kaistseed/jahwa-project/README.md

<table width="100%" align="center" style="border:0px solid white;>
 <tr width="100%">
    <td align="center">
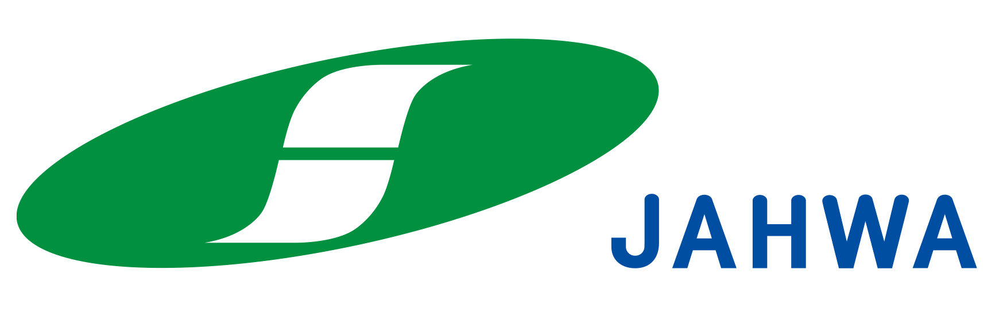
[picture p1: documentation/resources/jahwa.png]
     <h1>Jahwa Project - Data Acquisition System</h1>
    </td>
 </tr>
</table>

## Repository Content

 <table style="width:100%" align="center">
 <tr>
 <td align="center"><b>Content</b>
 <td align="center"><b>Target / Platform</b>
 <td align="center"><b>Note</b>
 </tr>
 <tr>
 <td align="center"><a href="https://github.com/kaistseed/jahwa-project/tree/main/fpga-board/vivado-project">Vivado Project Guide</a></td>
 <td align="center">FPGA Board</td>
 <td align="center">Contains tutorial and necessary files to build an FPGA overlay using Xilinx Vivado tools</td>
 </tr>
 <tr>
 <td align="center"><a href="https://github.com/kaistseed/jahwa-project/tree/main/fpga-board/vitis-project">Vitis Project Guide</a></td>
 <td align="center">FPGA Board</td>
 <td align="center">Contains tutorial and necessary files to create firmware for controlling the MicroBlaze processor and other IP blocks</td>
 </tr>
 <tr>
 <td align="center"><a href="">Board Calibration Guide</a></td>
 <td align="center">Host PC and FPGA Board</td>
 <td align="center">Contains files that are required to perform board calibration</td>
 </tr>
 <tr>
 </table>
