kaistseed/jahwa-project/documentation/resources/bd-automation-tcl.png

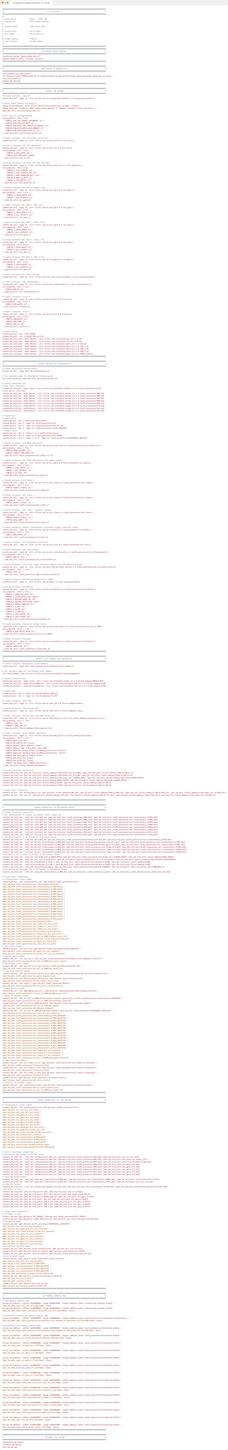
documentation/resources/bd-automation-tcl.png
