kaistseed/jahwa-project/documentation/resources/gpio-emio.png

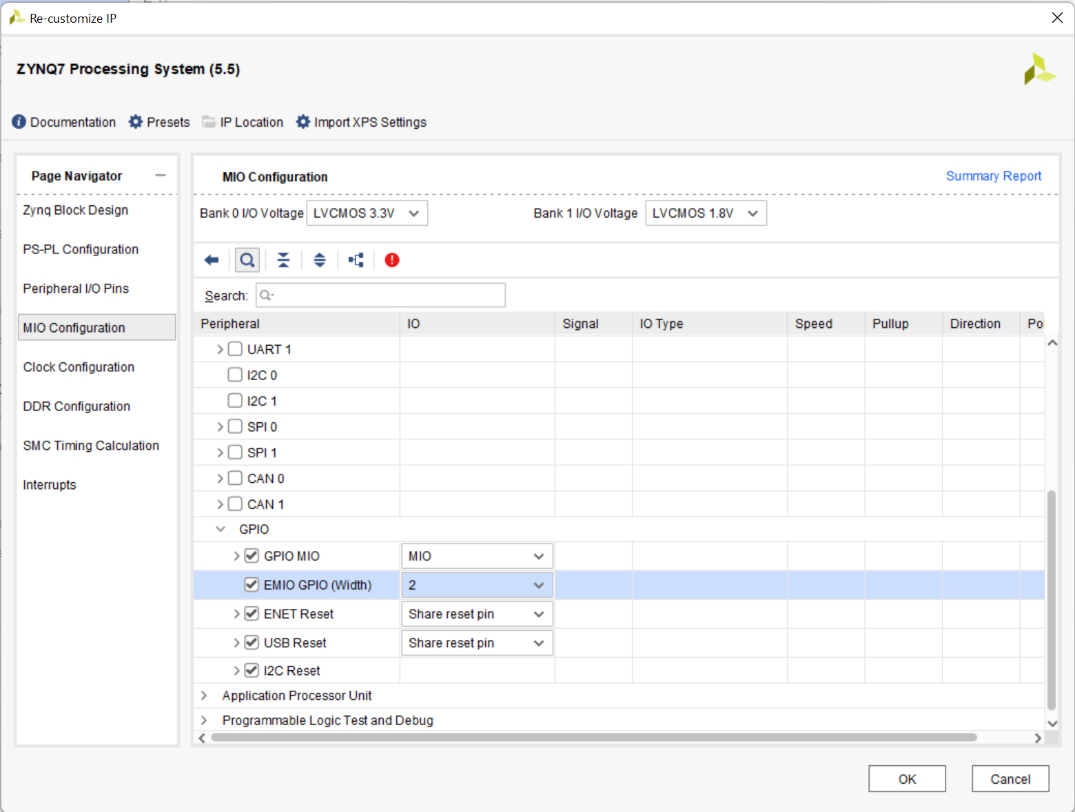
documentation/resources/gpio-emio.png
