kaistseed/jahwa-project/documentation/resources/initial-bd.png

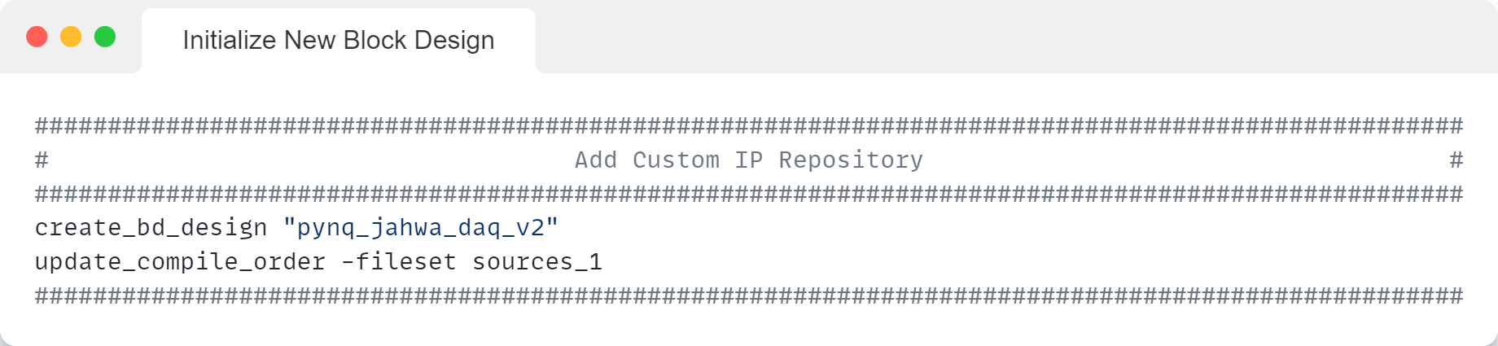
documentation/resources/initial-bd.png
