kaistseed/jahwa-project/documentation/resources/zynq-interrupt.png

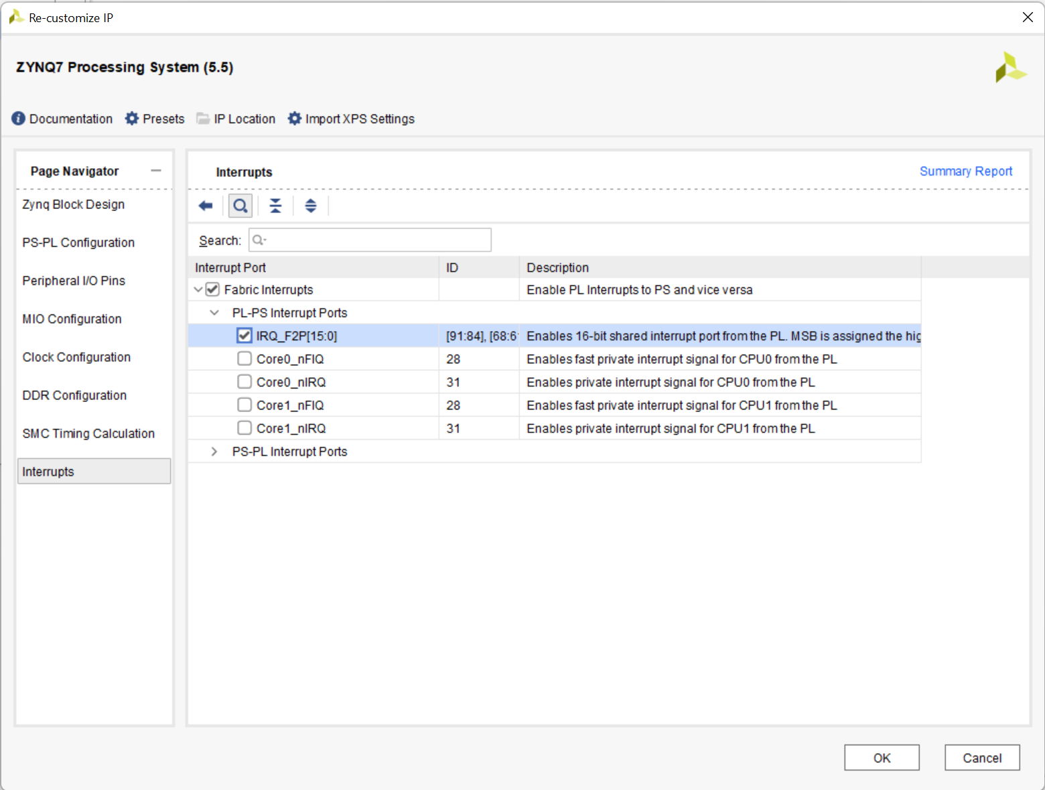
documentation/resources/zynq-interrupt.png
