kaistseed/jahwa-project/pcb-board/Jahwa_2 BOM v2.xlsx

Comment | Description | Designator | Footprint | LibRef | Quantity | Unit price[KRW] | Total price | How many we will send | Link
100n | Multi-layer Ceramic Capacitor, -55 to 125 degC, 2-Pin SMD (0603), RoHS, Tape and Reel | C100, C101, C105, C106, C109, C110, C114, C115, C201, C204, C302A, C302O, C303A, C303O, C304A, C304O, C306A, C306O, C307A, C307O, C308A, C308O, C309A, C309O, C400, C401, C402, C408, C409, C410, C500, C502, C503, C504, C505, C600, C601 | SAMS-C0603-2_M | CMP-2000-05332-1 | 37 | 0 | 0
10uF 16V 3528 | CAP TANT 10UF 10% 20V 1411 | C102, C103, C104, C107, C108, C111, C112, C200, C403, C406, C501 | FP-T491B106K020AT-MFG | CMP-2000-07191-2 | 11 |  | 0
10n | CAP CER 10000PF 200V X7R 0603 | C113, C116 | FP-C0603C-CF-MFG | CMP-2006-03038-2 | 2 |  | 0
100u 25V | CAP TANT 100UF 10% 25V 2917 | C117, C300A, C300O, C301A, C301O | FP-T491X107K025AT-MFG | CMP-2000-07204-2 | 5 |  | 0
2.2uF | Cap Ceramic 2.2uF 10V X7R ±10% Pad SMD 0603 +125°C T/R | C202 | FP-CL10-IPC_A | CMP-13271-003582-1 | 1 |  | 0
47uF 3528 | 47uF 10V ±10% 1Ω 1210 SMD Tantalum Capacitor | C203 | FP-TAJB-MFG | CMP-04424-000629-1 | 1 |  | 0
1u |  | C404, C405 | CAPC2013X70X45NL10T25 | CMP-2007-00957-1 | 2 |  | 0
BAT54HT1G | Schottky Barrier Diode, 2-Pin SOD-323, Pb-Free, Tape and Reel | D300A, D300O | ONSC-SOD-323-2-477-02_V | CMP-1055-00462-1 | 2 | 219.9 | 439.8 |  | https://www.mouser.kr/ProductDetail/onsemi/BAT54HT1G?qs=vLkC5FC1VN%252BK3ZQA%252ByHPIA%3D%3D
G6K-2F-Y DC3 | RELAY TELECOM DPDT 1A 3VDC | K300A, K300O | FP-G6K-2F-Y_DC3-MFG | CMP-08823-000016-1 | 2 | 5800.70 | 11601.4 |  | https://www.mouser.com/ProductDetail/Omron-Electronics/G6K-2F-DC3?qs=eORE%252BZ%252B0Crt4AHji2fVKVw%3D%3D
3mm |  | MNT1, MNT2, MNT3, MNT4 | 3mm Hole | Hole 3mm | 4 |  | 0
691311500102 | Serie 311 - 5.08mm Close Vertical PCB Header WR-TBL, 2 pin | P100 | 691311500102 | CMP-1502-02146-1 | 1 |  | 0 | 3
B4B-PH-K-S(LF)(SN) | Male Header, Pitch 2 mm, 1 x 4 Position, Height 6 mm, Tail Length 3.4 mm, -25 to 85 degC, RoHS, Bulk | P400, P402 | JST-B4B-PH-K-S_V | CMP-2000-05165-1 | 2 |  | 0
22035085 | 2.50mm Pitch, Mini-SPOX PCB Header, Single Row, Vertical, Through Hole, Tin Plating, 8 Circuits, Bag, 3.50mm PC Tail Length | P401 | MOLEX_22035085 | 22035085 | 1 |  | 0 | 10+
61300211121 | THT Vertical Pin Header WR-PHD, Pitch 2.54 mm, Single Row, 2 pins | P600 | 61300211121 | CMP-1712-00002-4 | 1 |  | 0
Pynq3 | Header, 10-Pin | P700 | HDR1X10 | Header 10 | 1 |  | 0
Pynq 1 | Header, 8-Pin | P701 | HDR1X8 | Header 8 | 1 |  | 0
Pynq 4 | Header, 8-Pin | P702 | HDR1X8 | Header 8 | 1 |  | 0
Pynq 2 | Header, 6-Pin | P703 | HDR1X6 | Header 6 | 1 |  | 0
MMBT3904LT1G | General Purpose Transistor, NPN Silicon, 3-Pin SOT-23, Pb-Free, Tape and Reel | Q300A, Q300O | ONSC-SOT-23-3-318-08_V | CMP-1048-00631-1 | 2 | 144.3 | 288.6 |  | https://www.mouser.kr/ProductDetail/onsemi/MMBT3904LT1G?qs=HVbQlW5zcXUYZ2Fy0YF3FQ%3D%3D
9k1 |  | R100 | RESC1608X55X30ML15T15 | CMP-2000-00683-1 | 1 |  | 0
100k |  | R101 | RESC1608X55X30ML15T15 | CMP-2000-00182-1 | 1 |  | 0
100R |  | R200, R201, R203, R204, R205, R500, R501, R502 | RESC1608X55X30ML15T15 | CMP-2000-00179-1 | 8 |  | 0
3k3 | Chip Resistors, 3.3 KOhm, +/- 1%, 0.1 W, 0603 (1608 Metric), -55 to 155 degC, RoHS, Tape and Reel | R202, R301A, R301O, R407, RP400 | RESC1609X55X30ML15T15 | CMP-2000-00436-2 | 5 |  | 0
24k |  | R300A, R300O | RESC1608X55X30ML15T15 | CMP-2000-00362-1 | 2 |  | 0
6k2 |  | R302A, R302O | RESC1608X55X30ML15T15 | CMP-2000-00594-1 | 2 |  | 0
0.2R 2012(0805) | RES Thick Film, 0.2Ω, 1%, 0.125W, 100ppm/°C, 0805 | R303A, R303O, R402 | RESC2013X46X38ML25T25 | CMP-2001-04350-1 | 3 | 370.8 | 1112.4 |  | https://www.digikey.kr/en/products/detail/stackpole-electronics-inc/CSR0805FKR200/1742442
12k |  | R304A, R304O | RESC1608X55X30ML15T15 | CMP-1012-00057-2 | 2 |  | 0
1.2k | Chip Resistor, 1.2 KOhm, +/- 1%, 0.1 W, -55 to 155 degC, 0603 (1608 Metric), RoHS, Tape and Reel | R305A, R305O, R403 | RESC1609X55X30ML15T15 | CMP-2000-00214-2 | 3 |  | 0
15k |  | R306A, R306O, R400 | RESC1608X55X30ML15T15 | CMP-2000-00460-1 | 3 |  | 0
10k |  | R307A, R307O, R312A, R312O, R401 | RESC1608X55X30ML15T15 | CMP-1012-00109-2 | 5 |  | 0
22R | Chip Resistor, 22 Ohm, +/- 1%, 0.1 W, -55 to 155 degC, 0603 (1608 Metric), RoHS, Tape and Reel | R308A, R308O | RESC1608X55X30ML15T15 | CMP-1012-00320-3 | 2 |  | 0
11k |  | R309A, R309O, R404 | RESC1608X55X30ML15T15 | CMP-2000-00199-1 | 3 |  | 0
1k |  | R310A, R310O, R405 | RESC1608X55X30ML15T15 | CMP-2000-00180-1 | 3 |  | 0
100R 0805 | RES Thick Film, 100Ω, 1%, 0.125W, 100ppm/°C, 0805 | R311A, R311O | FP-CRCW0805-e3-MFG | CMP-1013-00397-3 | 2 | 2214.30 | 4428.6 |  | https://www.digikey.kr/en/products/detail/stackpole-electronics-inc/RNCF0805TKY100R/2269699
10k | Chip Resistor, 10 KOhm, +/- 1%, 0.1 W, -55 to 155 degC, 0603 (1608 Metric), RoHS, Tape and Reel | R406 | RESC1609X55X30ML15T15 | CMP-1012-00623-3 | 1 |  | 0
20k | Chip Resistor, 10 KOhm, +/- 1%, 0.1 W, -55 to 155 degC, 0603 (1608 Metric), RoHS, Tape and Reel | R408 | RESC1609X55X30ML15T15 | CMP-1012-00623-3 | 1 |  | 0
4k7 | Precision Thick Film Chip Resistor, 4.7 KOhm, +/- 1%, -55 to 155 degC, 0603 (1608 Metric), RoHS, Tape and Reel | R409 | RESC1608X55X30ML15T15 | CMP-1012-00586-3 | 1 |  | 0
2k |  | R410, R411, R412, R413 | RESC1608X55X30ML15T15 | CMP-2000-00317-1 | 4 |  | 0
120R |  | R503, R504, R505 | RESC1608X55X30ML15T15 | CMP-2000-00179-1 | 3 |  | 0
LM3940IMP-3.3 | 1A Low Dropout Regulator for 5V to 3.3V Conversion, 4-pin SOT-223 | U100 | DCY0004A_L | CMP-0062-01793-3 | 1 | 3575 | 3575 |  | https://www.digikey.com/en/products/detail/texas-instruments/LM3940IMP-3-3/3697827
L7809ABD2T-TR | Positive Voltage Regulator, 3-Pin D2PAK, Tape and Reel | U101 | TO-263_N | CMP-0244-00211-1 | 1 | 1528 | 1528 |  | https://www.digikey.kr/en/products/detail/stmicroelectronics/L7809ABD2T-TR/1038253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
LM2937IMP-5.0/NOPB | 500 mA Low Dropout Regulator, 4-pin SOT-223, Pb-Free | U102 | DCY0004A_L | CMP-0062-01757-3 | 1 | 3442 | 3442 |  | https://www.digikey.kr/en/products/detail/texas-instruments/LM2937IMP-5-0-NOPB/270713
TPS7A4901DRBR | None | U103 | FP-DRB0008A-MFG | CMP-04917-000048-2 | 1 | 3788 | 3788 |  | https://www.digikey.kr/en/products/detail/texas-instruments/TPS7A4901DRBR/5278906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
LTC2345HUK-16#PBF | IC ADC 16BIT SAR 48QFN | U200 | FP-UK-48-05-08-1704-MFG | CMP-09081-000619-1 | 1 | 54308 | 54308 | 5 | https://www.digikey.kr/en/products/detail/analog-devices-inc/LTC2345HUK-16-PBF/5965258
TL1963A-Q1 | Single Output Fast Transient Response LDO, 1.5 A, Adjustable 1.21 to 20 V Output, 2.1 to 20 V Input, 5-pin DDPAK (KTT), -40 to 125 degC, Green (RoHS & no Sb/Br) | U300A, U300O | KTT0005A_M | CMP-0395-00836-2 | 2 | 5503 | 11006 | 25 | https://www.digikey.kr/en/products/detail/texas-instruments/TL1963AQKTTRQ1/2295639
AD8422ARZ | IC INST AMP 1 CIRCUIT 8SOIC | U301A, U301O, U400 | FP-R-8-IPC_A | CMP-09116-000053-1 | 3 | 8930.40 | 26791.2 | 20 | https://www.mouser.com/ProductDetail/Analog-Devices/AD8422ARZ?qs=7RyRc4g%252BU4rE%2FSk2G%252BSHmQ%3D%3D
AD8602ARZ | Double Channel Wide Bandwidth Operational Amplifier, 8.4 MHz BW, 6 V/us SR, Industrial, 8-pin SOIC (R-8), Tube | U302A, U302O, U401 | ADI-R-8_N | CMP-0384-00551-1 | 3 | 3450 | 10350 |  | https://www.digikey.kr/en/products/detail/analog-devices-inc/AD8602ARZ/751180
ISL21080CIH315Z-TK | IC VREF SERIES 0.5% SOT23-3 | U305A, U305O, U402 | FP-P3_064A-IPC_A | CMP-13559-000003-1 | 3 |  | 0 | 30
OP1177ARZ | Single Channel Wide Bandwidth Operational Amplifier, 1.3 MHz BW, 700 mV/us SR, Industrial, 8-pin SOIC (R-8), Tube | U306A, U306O, U403 | ADI-R-8_M | CMP-0384-00637-2 | 3 | 3386 | 10158 |  | https://www.digikey.kr/en/products/detail/analog-devices-inc/op1177arz/1007331
TPS78401QWDRBRQ1 | No Description Available | U404 | DRB0008J-IPC_A | TPS78401QWDRBRQ1 | 1 | 1099.20 | 1099.2 |  | https://www.digikey.kr/en/products/detail/texas-instruments/TPS78401QWDRBRQ1/14124017
TCA9416DDFR | No Description Available | U405 | SOT_16DDFR_TEX | TCA9416DDFR | 1 | 990.2 | 990.2 |  | https://www.digikey.kr/en/products/detail/texas-instruments/TCA9416DDFR/15222332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
DAC124S085CIMM/NOPB | 12-Bit Micro Power QUAD Digital-to-Analog Converter with Rail-to-Rail Output, 10-pin Mini SOIC, Pb-Free | U500 | MUB10A_L | CMP-0061-00134-2 | 1 |  | 0 | 10
LM4132AMF-4.1/NOPB | IC VREF SERIES 0.05% SOT23-5 | U501 | FP-DBV0005A-IPC_C | CMP-04916-000024-1 | 1 | 4831.40 | 4831.4 |  | https://www.digikey.kr/en/products/detail/texas-instruments/LM4132AMF-4-1-NOPB/1590083
TXS0101DCKR | IC TRNSLTR BIDIRECTIONAL SC70-6 | U600 | FP-DCK0006A-MFG | CMP-04899-000067-1 | 1 | 677.9 | 677.9 |  | https://www.digikey.kr/en/products/detail/texas-instruments/TXS0101DCKR/1739893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
 |  |  |  |  |  | TOTAL PRICE | 150415.7
All pasive components 0603 unless mentioned otherwise
