kaistseed/jahwa-project/(list of files, drawings)

Other design files:
pcb-board/ADC.SchDoc
pcb-board/Connectors.SchDoc
pcb-board/DAC.SchDoc
pcb-board/Hole.PcbLib
pcb-board/Hole.SchLib
pcb-board/Jahwa_2.PrjPcb
pcb-board/Level_shifter.SchDoc
pcb-board/Power.SchDoc
pcb-board/Source_VDDM.SchDoc
pcb-board/Source_VDDP.SchDoc
pcb-board/Top.SchDoc
