kaistseed/jahwa-project/(commit log)

2023-02-27 Add python sensor library for PYNQ
2023-02-27 Prettify log printing
2023-02-27 Replace time delay with interrupt timer in meissner library
2023-02-27 Fix indexing bug in test i2c connection function
2023-02-27 Fix log printing
2023-02-27 Fix issue in interrupt timer usage inside library
2023-02-27 Fix bug in AXI I2C IP configuration
2023-02-27 Fix bug when reading sensor supply voltage
2023-03-02 Add feature to select slave and fix spi write problem
2023-03-02 Add read adc function and add channel code to dac configuration
2023-03-02 Add new packet and response for read adc
2023-03-02 Add function handler for read adc
2023-03-02 Fix bug in configure dac and read adc function
2023-03-02 Update protolib in the fpga-board
2023-03-02 Fix ADC start IO bug - set IO direction to output
2023-03-02 Add method to reset and start ADC
2023-03-14 Modify code to support adc test
2023-03-21 Prettify print
2023-03-21 Add refactored basic grpc code for controlling meissner sensor
2023-05-16 Add ADC-DAC calibration codes
2023-05-16 Fix bug in server packet decoder & client encoder
2023-05-16 Print status everytime sending packet to server
2023-05-17 Adjust code for testing on PYNQ board
2023-05-17 Add library for handling SPI and GPIO operation
2023-05-17 Change code to support SPI and GPIO
2023-05-17 Change code to support I2C Testing
2023-06-13 Add new bitstream with laser trigger IP
2023-07-26 Add code for PCB calibration
    [test_voltage_OIS.csv]
2023-07-26 Update the calibration code
2023-07-26 Remove unused calibration program
2023-09-13 Remove old code from main branch
    [test_voltage_OIS.csv]
2023-09-19 PCB v2 schematic, layout, documents uploaded
    [ADC.SchDoc, Connectors.SchDoc, DAC.SchDoc, Hole.PcbLib, Hole.SchLib, Jahwa_2 BOM v2.xlsx, Jahwa_2 BOM.xlsx, Jahwa_2.PrjPcb]
2023-09-21 Add PC and PYNQ python code for calibration
2023-09-21 Rename PCB directory
    [ADC.SchDoc, Connectors.SchDoc, DAC.SchDoc, Hole.PcbLib, Hole.SchLib, Jahwa_2 BOM v2.xlsx, Jahwa_2 BOM.xlsx, Jahwa_2.PrjPcb]
2023-10-04 Calibration client file with adjusted ADC channels
2023-10-12 Add test sequence for laser trigger
2023-10-23 Fix laser trigger problem in Vitis code
    [main.c]
